Alan-JH/BattTester/BattTester/BattTester.kicad_pcb

## KiCad design BattTester/BattTester.kicad_pcb (2021-11-26)

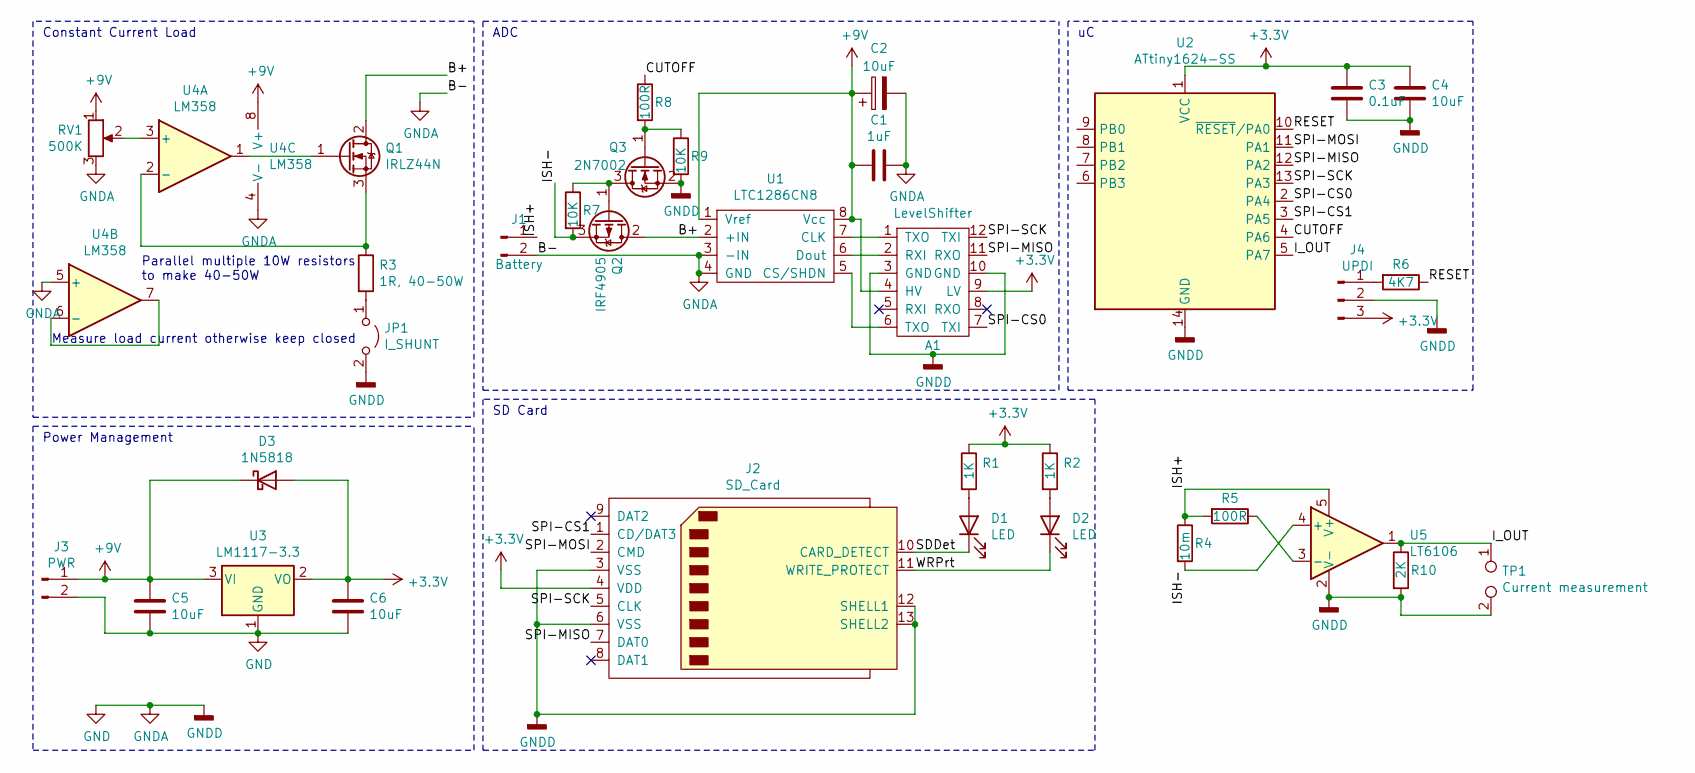
[picture p1: schematic BattTester.sch, 2S Battery Discharge Tester]

Parts:
A1: LevelShifter; LevelShifterBreakout
C1: 1uF; C_0805_2012Metric_Pad1.18x1.45mm_HandSolder
C2: 10uF; C_1206_3216Metric_Pad1.33x1.80mm_HandSolder
C3: 0.1uF; C_0805_2012Metric_Pad1.18x1.45mm_HandSolder
C4, C5, C6: 10uF; C_0805_2012Metric_Pad1.18x1.45mm_HandSolder
D1, D2: LED; LED_0805_2012Metric_Pad1.15x1.40mm_HandSolder
D3: 1N5818; D_DO-15_P10.16mm_Horizontal
J1: Battery; PinHeader_1x02_P2.54mm_Vertical
J2: SD_Card; SD_TE_2041021
J3: PWR; PinHeader_1x02_P2.54mm_Vertical
J4: UPDI; PinHeader_1x03_P2.54mm_Vertical
JP1: I_SHUNT; PinHeader_1x02_P2.54mm_Vertical
Q1: IRLZ44N; TO-220-3_Vertical
Q2: IRF4905; TO-220-3_Vertical
Q3: 2N7002; SOT-23
R1, R2: 1K; R_1206_3216Metric_Pad1.30x1.75mm_HandSolder
R3: 1R, 40-50W; 10xParallel_R_Axial_DIN0614_L14.3mm_D5.7mm_P15.24mm_Horizon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
R4: 10m; R_2816_7142Metric_Pad3.20x4.45mm_HandSolder
R5: 100R; R_0805_2012Metric_Pad1.20x1.40mm_HandSolder
R6: 4K7; R_1206_3216Metric_Pad1.30x1.75mm_HandSolder
R7, R9: 10K; R_1206_3216Metric_Pad1.30x1.75mm_HandSolder
R8: 100R; R_1206_3216Metric_Pad1.30x1.75mm_HandSolder
R10: 2K; R_0805_2012Metric_Pad1.20x1.40mm_HandSolder
RV1: 500K; PinHeader_1x03_P2.54mm_Vertical
TP1: Current measurement; PinHeader_1x02_P2.54mm_Vertical
U1: LTC1286CN8; DIP-8_W7.62mm_Socket
U2: ATtiny1624-SS; SOIC-14_3.9x8.7mm_P1.27mm
U3: LM1117-3.3; TO-220-3_Vertical
U4: LM358; DIP-8_W7.62mm_Socket
U5: LT6106; SOT-23-5

Connections:
+3V3: A1.9 (LV), C3.1, C4.1, C6.1, D3.2 (A), J2.4 (VDD), J4.3, R1.1, R2.1, U2.1 (VCC), U3.2 (VO)
+9V: A1.4 (HV), C1.2, C2.1, C5.1, D3.1 (K), J3.1, RV1.1, U1.1 (Vref), U1.8 (Vcc), U3.3 (VI), U4.8 (V+)
/B+: Q1.2 (D), Q2.2 (D), U1.2 (+IN)
/CUTOFF: R8.1, U2.4 (PA6)
/ISH+: J1.1, R4.1, R5.2, U5.5 (V+)
/ISH-: Q2.3 (S), R4.2, R7.2, U5.4 (+)
/I_OUT: R10.1, TP1.1, U2.5 (PA7), U5.1
/RESET: R6.1, U2.10 (~RESET~/PA0)
/SDDet: D1.1 (K), J2.10 (CARD_DETECT)
/SPI-CS0: A1.7 (TXI), U2.2 (PA4)
/SPI-CS1: J2.1 (CD/DAT3), U2.3 (PA5)
/SPI-MISO: A1.11 (RXO), J2.7 (DAT0), U2.12 (PA2)
/SPI-MOSI: J2.2 (CMD), U2.11 (PA1)
/SPI-SCK: A1.12 (TXI), J2.5 (CLK), U2.13 (PA3)
/WRPrt: D2.1 (K), J2.11 (WRITE_PROTECT)
GND: A1.3 (GND), A1.10 (GND), C1.1, C2.2, C3.2, C4.2, C5.2, C6.2, J1.2, J2.3 (VSS), J2.6 (VSS), J2.12 (SHELL1), J2.13 (SHELL2), J3.2, J4.2, JP1.2 (B), Q3.2 (S), R9.2, R10.2, RV1.3, TP1.2, U1.3 (-IN), U1.4 (GND), U2.14 (GND), U3.1 (GND), U4.4 (V-), U4.5 (+), U5.2 (V-)
unnamed: A1.1 (TXO), U1.7 (CLK)
unnamed: A1.2 (RXI), U1.6 (Dout)
unnamed: A1.6 (TXO), U1.5 (CS/SHDN)
unnamed: D1.2 (A), R1.2
unnamed: D2.2 (A), R2.2
unnamed: J4.1, R6.2
unnamed: JP1.1 (A), R3.2
unnamed: Q1.1 (G), U4.1
unnamed: Q1.3 (S), R3.1, U4.2 (-)
unnamed: Q2.1 (G), Q3.3 (D), R7.1
unnamed: Q3.1 (G), R8.2, R9.1
unnamed: R5.1, U5.3 (-)
unnamed: RV1.2, U4.3 (+)
unnamed: U4.6 (-), U4.7

Notes on the sheet:
Measure load current otherwise keep closed
Power Management
Constant Current Load
ADC
SD Card
Parallel multiple 10W resistors to make 40-50W

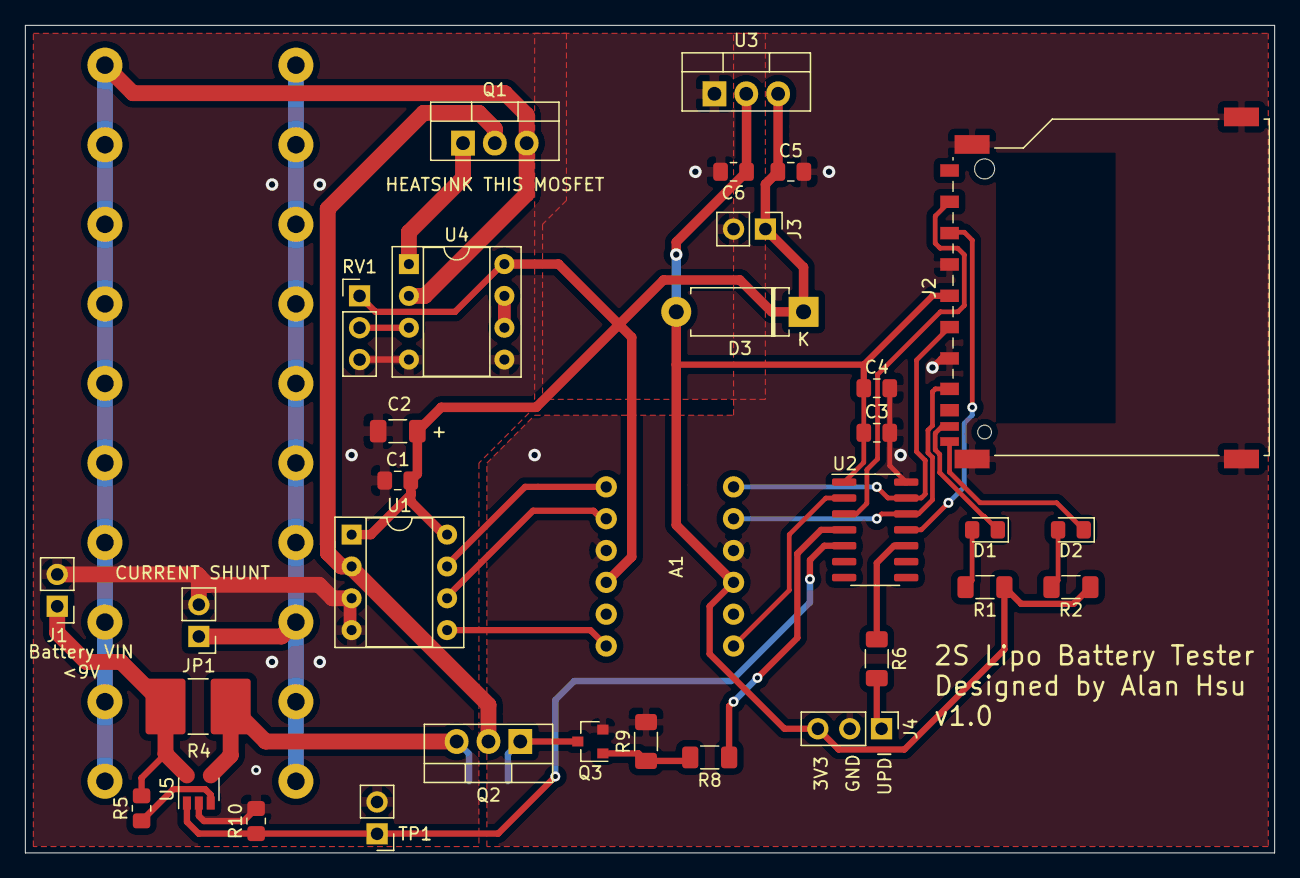
[picture p2: board BattTester.kicad_pcb from above]

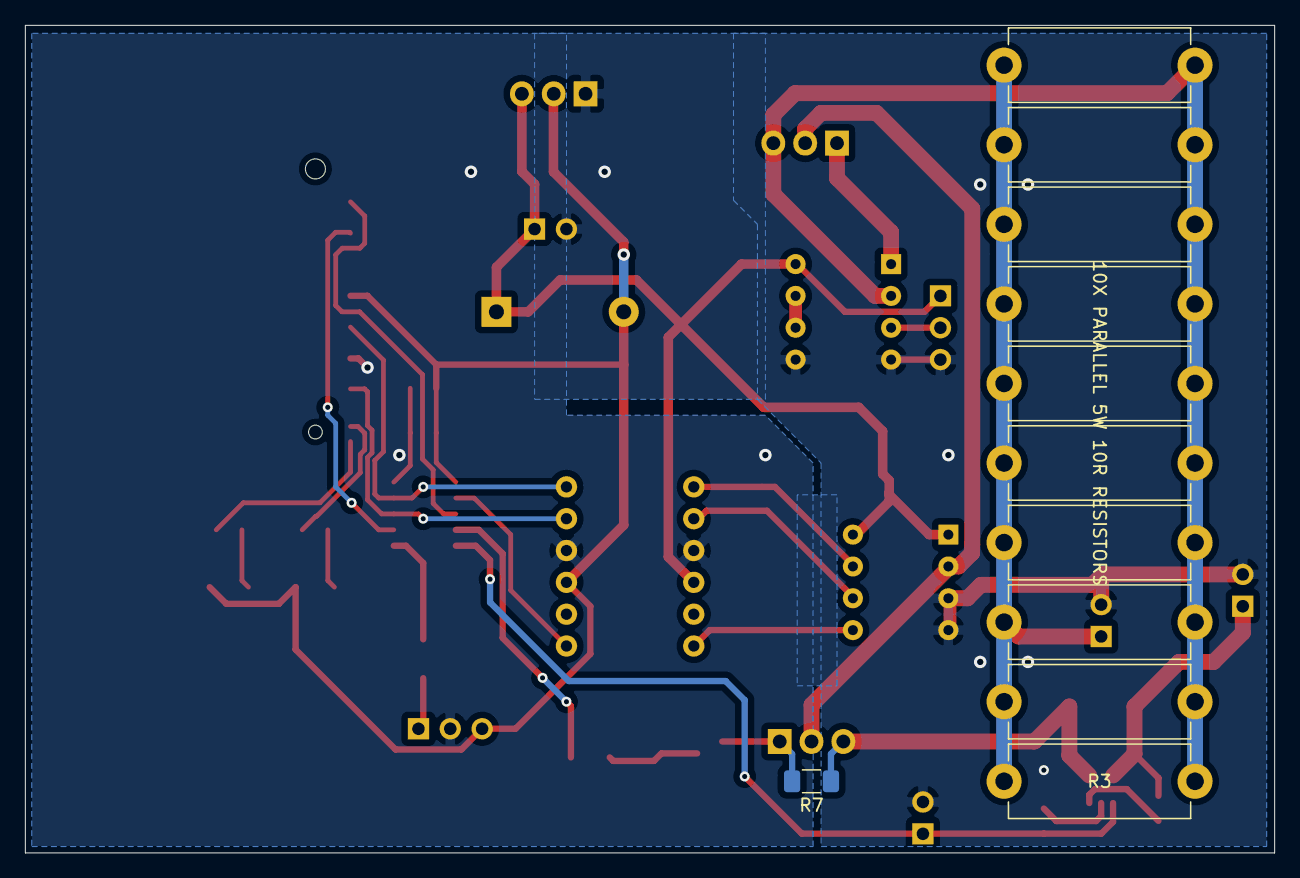
[picture p3: board BattTester.kicad_pcb from below]

Board: 2 copper layers, 99.7 x 66.0 mm, 35 parts (2 on the bottom side), 30 nets.
