Alan-JH/BattTester/(threads)

Thread 1 (2021-10-25):

Incorrect P channel mosfet configuration

Alan-JH, 2021-10-25:
P channel mosfet is configured incorrectly, needs an npn or n channel fet to keep vgs at 0 when switched off

Closed 2021-11-13.
