Alan-JH/BattTester/(commit log)

2021-10-17 Constant current load
    [BattTester.sch]
2021-10-17 level shifter placeholder
    [BattTester.sch]
2021-10-17 Clean up schematic, add level shifter breakout
    [BattTester.sch]
2021-10-18 Finish routing
    [BattTester-B_Cu.gbr, BattTester-B_Mask.gbr, BattTester-B_Paste.gbr, BattTester-B_SilkS.gbr, BattTester-Edge_Cuts.gbr, BattTester-F_Cu.gbr, BattTester-F_Mask.gbr, BattTester-F_Paste.gbr]
2021-10-18 minor name fix
    [BattTester.kicad_pcb, BattTester.sch]
2021-10-18 fix updi header
    [BattTester-B_Cu.gbr, BattTester-B_Mask.gbr, BattTester-B_Paste.gbr, BattTester-B_SilkS.gbr, BattTester-Edge_Cuts.gbr, BattTester-F_Cu.gbr, BattTester-F_Mask.gbr, BattTester-F_Paste.gbr]
2021-10-18 minor sch edit
    [BattTester.sch]
2021-10-18 cutoff mosfet and higher power Rload
    [BattTester.kicad_pcb, BattTester.sch]
2021-10-18 silkscreen update
    [BattTester.kicad_pcb]
2021-10-19 work on things
    [BattTester-B_Cu.gbr, BattTester-B_Mask.gbr, BattTester-B_Paste.gbr, BattTester-B_SilkS.gbr, BattTester-Edge_Cuts.gbr, BattTester-F_Cu.gbr, BattTester-F_Mask.gbr, BattTester-F_Paste.gbr]
2021-11-13 Fix #1
    [BattTester.kicad_pcb, BattTester.sch]
2021-11-14 start on firmware, export gerbers
    [BattTester-B_Cu.gbr, BattTester-B_Mask.gbr, BattTester-B_Paste.gbr, BattTester-B_SilkS.gbr, BattTester-Edge_Cuts.gbr, BattTester-F_Cu.gbr, BattTester-F_Mask.gbr, BattTester-F_Paste.gbr]
2021-11-17 update gerbers, finish firmware
    [BattTester-B_Cu.gbr, BattTester-B_Mask.gbr, BattTester-B_Paste.gbr, BattTester-B_SilkS.gbr, BattTester-Edge_Cuts.gbr, BattTester-F_Cu.gbr, BattTester-F_Mask.gbr, BattTester-F_Paste.gbr]
2021-11-18 current check
    [BattTester.sch]
2021-11-19 add current sense
    [BattTester.kicad_pcb, BattTester.sch]
2021-11-19 add current measurement
2021-11-24 finished routing
    [BattTester-B_Cu.gbr, BattTester-B_Mask.gbr, BattTester-B_Paste.gbr, BattTester-B_SilkS.gbr, BattTester-Edge_Cuts.gbr, BattTester-F_Cu.gbr, BattTester-F_Mask.gbr, BattTester-F_Paste.gbr]
2021-11-24 add test point
    [BattTester-B_Cu.gbr, BattTester-B_Mask.gbr, BattTester-B_Paste.gbr, BattTester-B_SilkS.gbr, BattTester-Edge_Cuts.gbr, BattTester-F_Cu.gbr, BattTester-F_Mask.gbr, BattTester-F_Paste.gbr]
2021-11-26 standardize dip-8, tie off second lm358 output
    [BattTester-B_Cu.gbr, BattTester-B_Mask.gbr, BattTester-B_Paste.gbr, BattTester-B_SilkS.gbr, BattTester-Edge_Cuts.gbr, BattTester-F_Cu.gbr, BattTester-F_Mask.gbr, BattTester-F_Paste.gbr]
